alttpo/pico-cart-snes/v1/v1-back.jpg

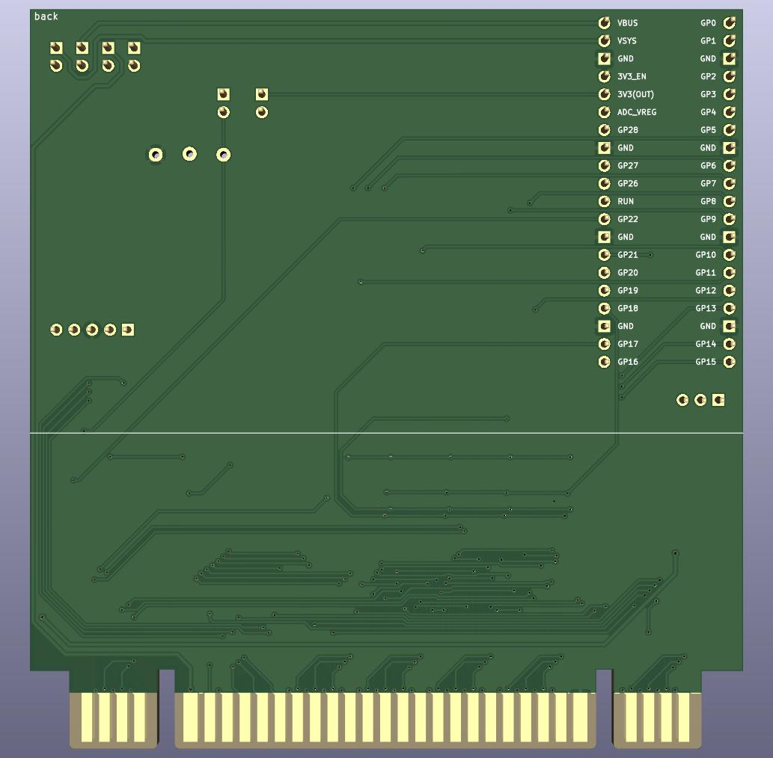
v1/v1-back.jpg
