alttpo/pico-cart-snes/v1/v1-front.jpg

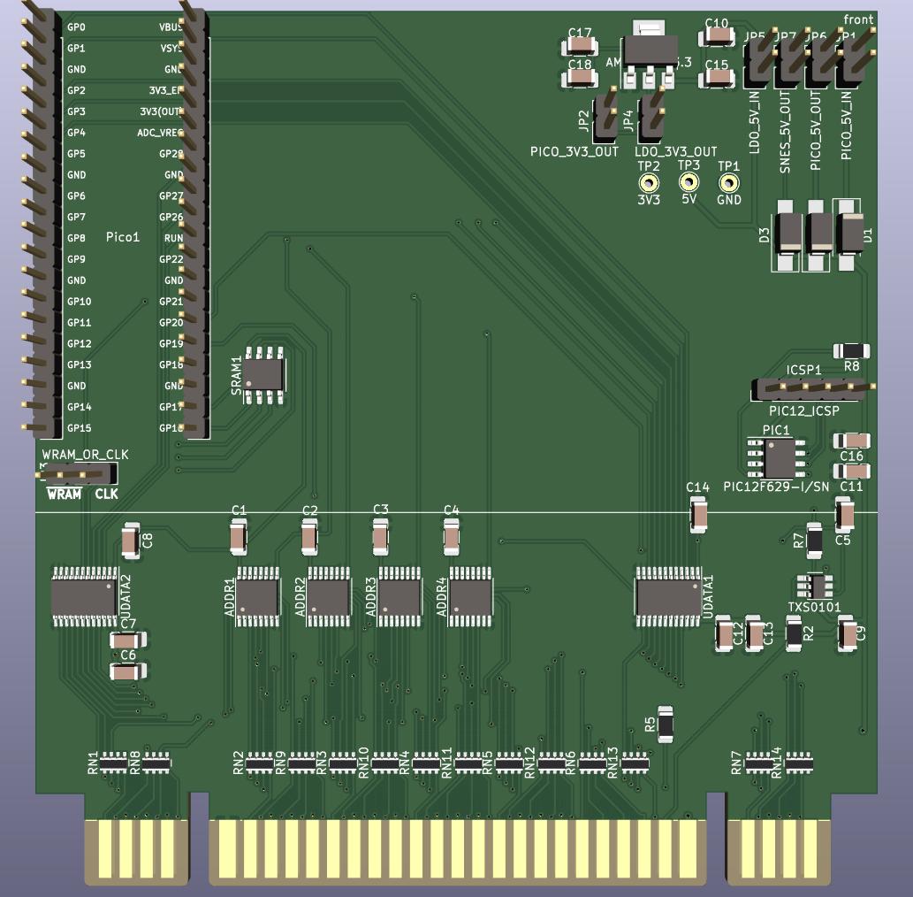
v1/v1-front.jpg
