alttpo/pico-cart-snes/README.md

# pico-cart-snes
Raspberry Pi Pico SNES flash cart (no SD card, WIP)
