alttpo/pico-cart-snes/(threads)

Thread 1 (2023-11-23):

how can i burn the snes rom into pico?

hualazimo7, 2023-11-23:
i got all the elements and the pcb, and what should i do next?

hualazimo7, 2023-11-23:
beg your help~

JamesDunne, 2023-11-23:
this project isn't capable of loading a rom yet.
