alttpo/pico-cart-snes/v1/v1.pdf

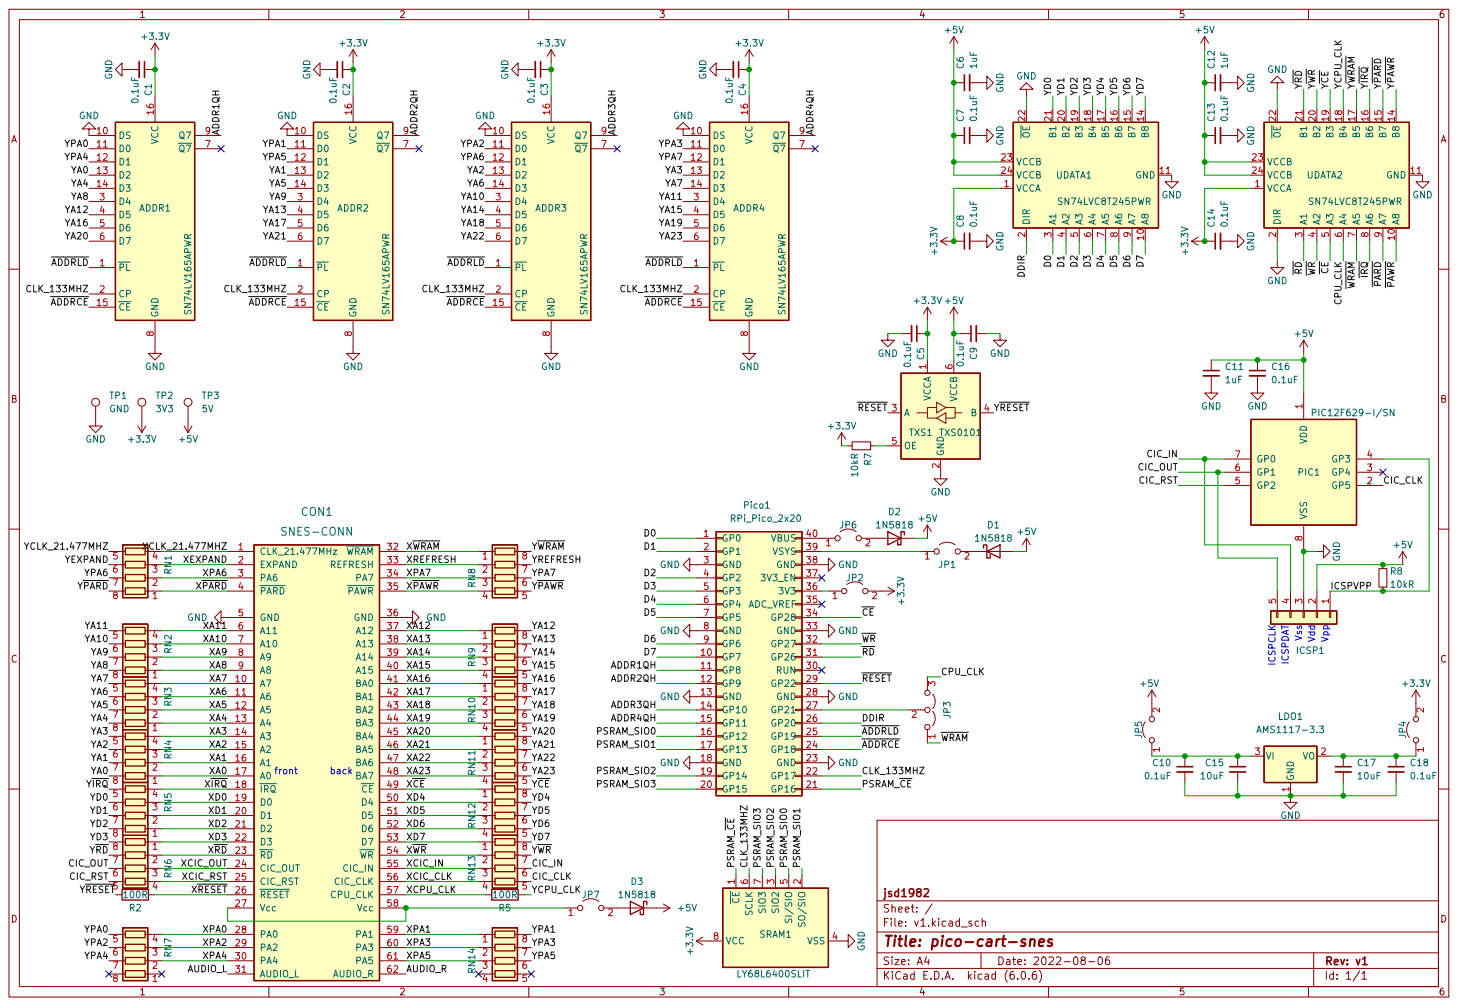
[picture p3: page 1]

A7 10 A6 11 A5 12 A4 13 A3 14 A2 15 A1 16 A0 17 ~{IRQ} 18 D0 19 EXPAND 2 D1 20 D2 21 D3 22 ~{RD} 23 CIC_OUT 24 CIC_RST 25 ~{RESET} 26 Vcc 27 PA0 28 PA2 29 PA6 3 PA4 30 AUDIO_L 31 | 1 | 8 RN14 CLK_21.477MHz 1

3 | | 2 | | 8 RN10 GND 8 RN9 7

3 | 2 | 8 RN11 7

X~{RD} XD2 XD3 XD1 XA1 X~{IRQ} XA0 | XCIC_CLK 1

3 | 2 | 8 RN12

1 | XD7 XCIC_IN 1
2 | 2 | R5 | 8 RN13 7

jsd1982
File: v1.kicad_sch Sheet: /
Id: 1/1 Title: pico-cart-snes
