alttpo/pico-cart-snes/v0/v0-schematic.pdf

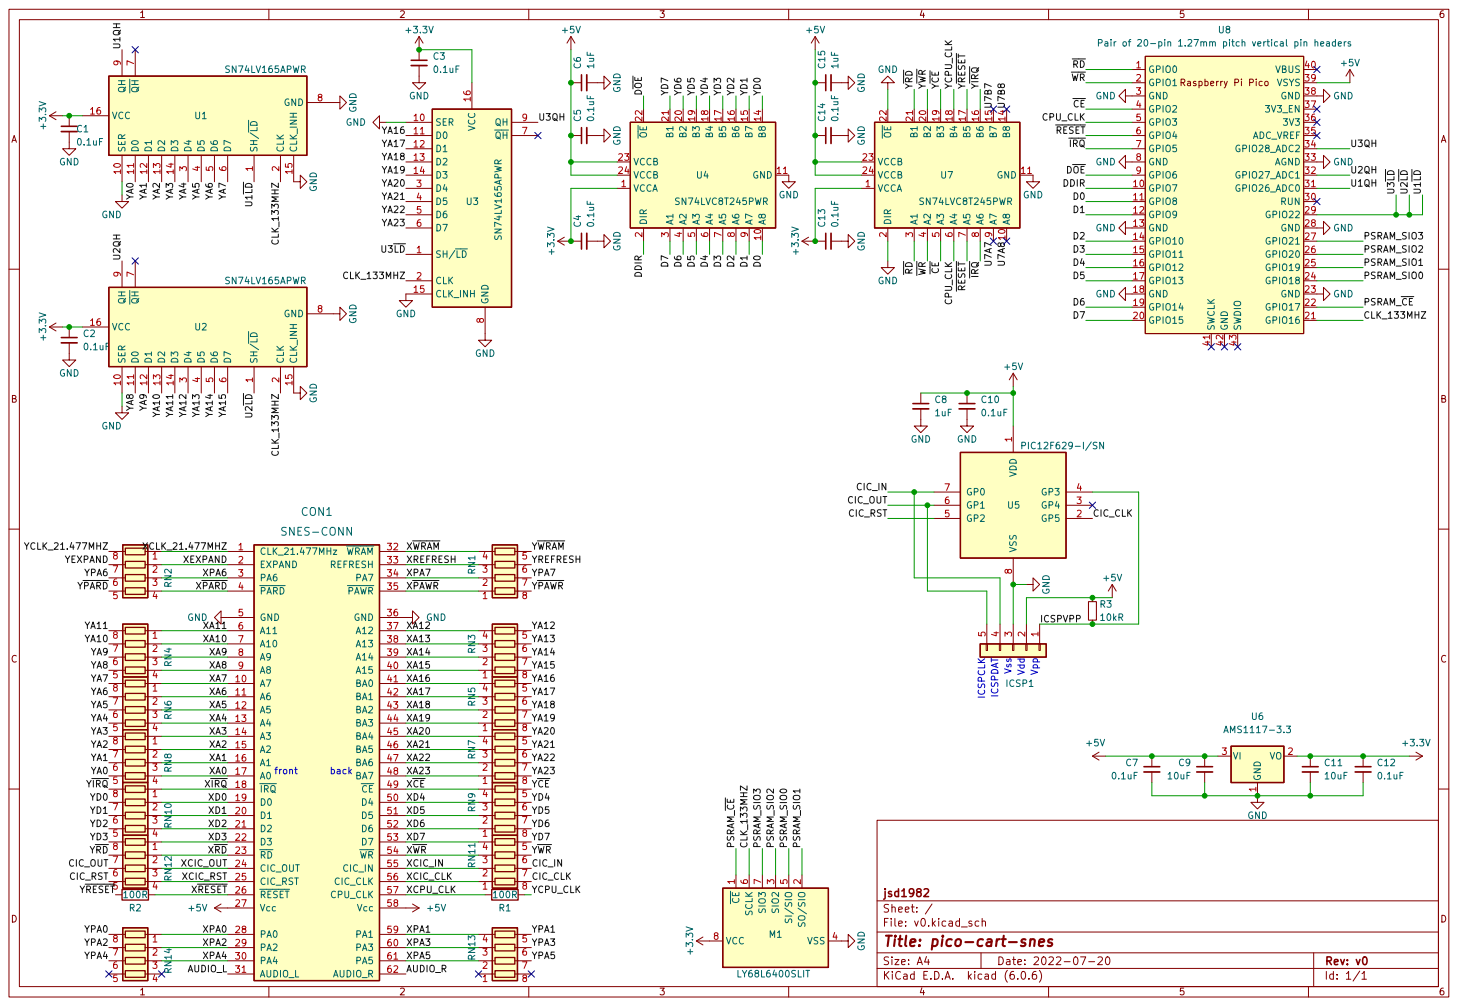
[picture p4: page 1]

9 U2 SN74LV165APWR SH/~{LD} 1 SER 10 D0 11 D1 12 D2 13 D3 14 CLK_INH 15 VCC 16 CLK

XPA4 AUDIO_L XA11 XA10 X~{PARD} 3 | 2

2 | 3 | 8 RN3 6

1 | 4 X~{WR} XCIC_IN | | 5
3 | XCIC_CLK 2 | R1 | 8 RN11 7

jsd1982
File: v0.kicad_sch Sheet: /
Id: 1/1 Title: pico-cart-snes
