alttpo/pico-cart-snes/v1/v1.kicad_pcb

## KiCad design v1/v1.kicad_pcb (2022-08-20)

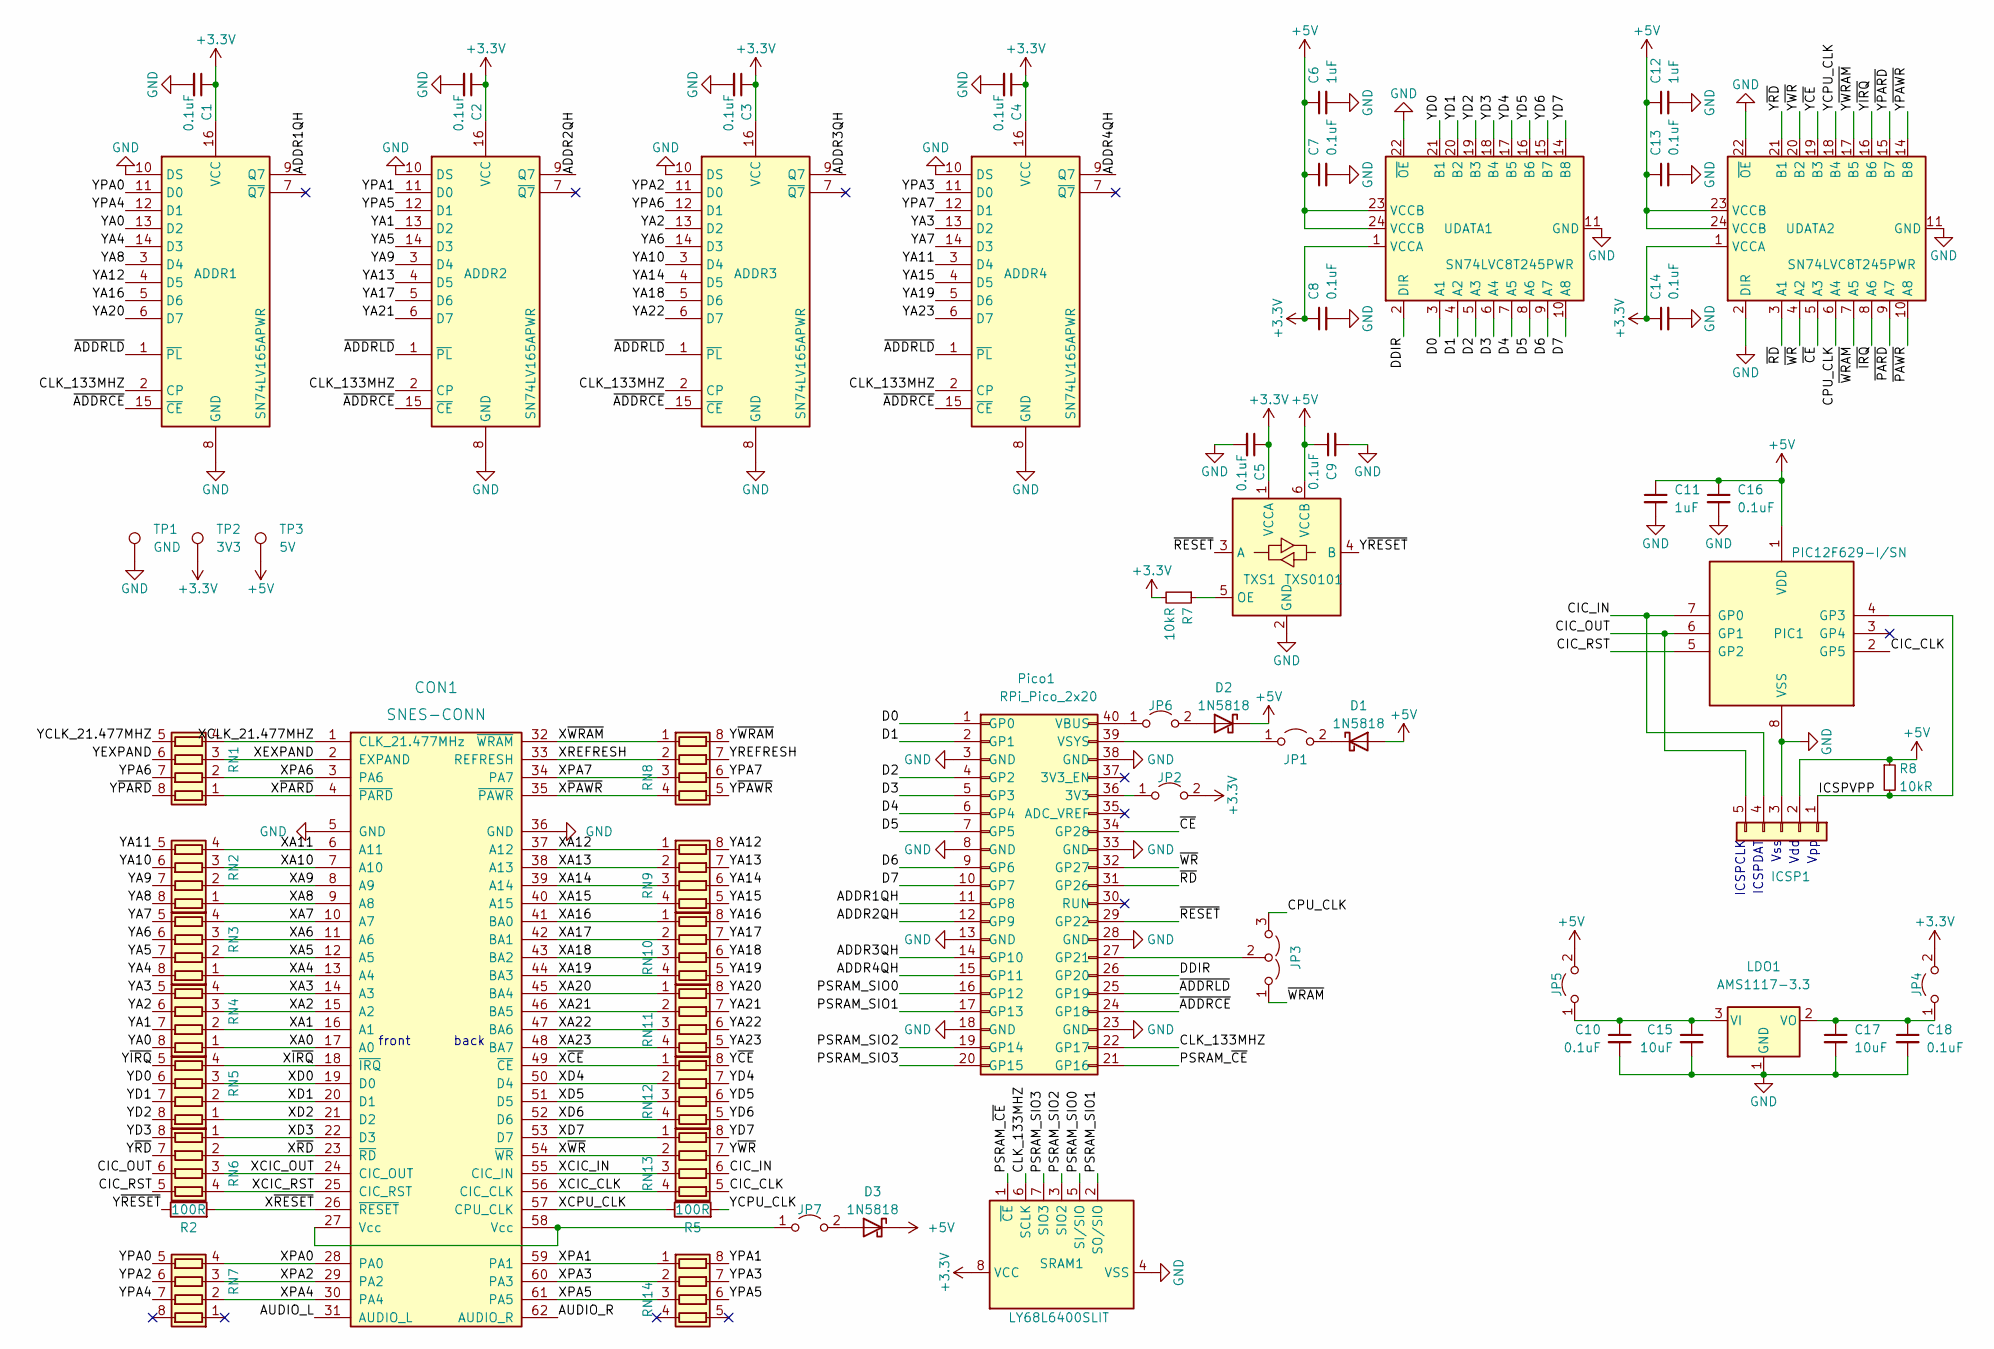
[picture p5: schematic v1.kicad_sch, pico-cart-snes]

Parts:
ADDR1, ADDR2, ADDR3, ADDR4: SN74LV165APWR; TSSOP-16_4.4x5mm_P0.65mm; LCSC C201716
C1, C2, C3, C4, C5, C7, C8, C9, C10, C13, C14, C16, C18: 0.1uF; C_1206_3216Metric_Pad1.33x1.80mm_HandSolder; JLC 1206
C6, C11, C12: 1uF; C_1206_3216Metric_Pad1.33x1.80mm_HandSolder; JLC 1206
C15, C17: 10uF; C_1206_3216Metric_Pad1.33x1.80mm_HandSolder; JLC 1206
CON1: SNES-CONN; SNESCART_EXT2
D1, D2, D3: 1N5818; D_SMA_Handsoldering; LCSC C513476
ICSP1: PIC12_ICSP; PinHeader_1x05_P2.54mm_Vertical; LCSC C390683
JP1: PICO_5V_IN; PinHeader_1x02_P2.54mm_Vertical; LCSC C390678
JP2: PICO_3V3_OUT; PinHeader_1x02_P2.54mm_Vertical; LCSC C390678
JP3: WRAM_OR_CLK; PinHeader_1x03_P2.54mm_Vertical; LCSC C390679
JP4: LDO_3V3_OUT; PinHeader_1x02_P2.54mm_Vertical; LCSC C390678
JP5: LDO_5V_IN; PinHeader_1x02_P2.54mm_Vertical; LCSC C390678
JP6: PICO_5V_OUT; PinHeader_1x02_P2.54mm_Vertical; LCSC C390678
JP7: SNES_5V_OUT; PinHeader_1x02_P2.54mm_Vertical; LCSC C390678
LDO1: AMS1117-3.3; SOT-223-3_TabPin2; LCSC C426566
PIC1: PIC12F629-I/SN; SOIC-8_3.9x4.9mm_P1.27mm; LCSC C8226
Pico1: RPi_Pico_2x20; LCSC C429964
R2, R5: 100R; R_1206_3216Metric_Pad1.30x1.75mm_HandSolder; JLC 1206
R7, R8: 10kR; R_1206_3216Metric_Pad1.30x1.75mm_HandSolder; JLC 1206
RN1, RN2, RN3, RN4, RN5, RN6, RN7, RN8, RN9, RN10, RN11, RN12, RN13, RN14: 100R; R_Array_Concave_4x0603; LCSC C79203
SRAM1: LY68L6400SLIT; SOIC-8_3.9x4.9mm_P1.27mm; LCSC C261881
TP1: GND; TestPoint_THTPad_D2.0mm_Drill1.0mm
TP2: 3V3; TestPoint_THTPad_D2.0mm_Drill1.0mm
TP3: 5V; TestPoint_THTPad_D2.0mm_Drill1.0mm
TXS1: TXS0101; SOT-23-6_Handsoldering; LCSC C2677420
UDATA1, UDATA2: SN74LVC8T245PWR; TSSOP-24_4.4x7.8mm_P0.65mm; LCSC C27643

Connections:
+3.3V: ADDR1.16 (VCC), ADDR2.16 (VCC), ADDR3.16 (VCC), ADDR4.16 (VCC), C1.1, C2.1, C3.1, C4.1, C5.1, C8.1, C14.1, JP2.2 (B), JP4.2 (B), R7.2, SRAM1.8 (VCC), TP2.1, TXS1.1 (VCCA), UDATA1.1 (VCCA), UDATA2.1 (VCCA)
+5V: C6.1, C7.1, C9.1, C11.1, C12.1, C13.1, C16.1, D1.2 (A), D2.1 (K), D3.1 (K), ICSP1.2, JP5.2 (B), PIC1.1 (VDD), R8.1, TP3.1, TXS1.6 (VCCB), UDATA1.23 (VCCB), UDATA1.24 (VCCB), UDATA2.23 (VCCB), UDATA2.24 (VCCB)
/ADDR1QH: ADDR1.9 (Q7), Pico1.11 (GP8)
/ADDR2QH: ADDR2.9 (Q7), Pico1.12 (GP9)
/ADDR3QH: ADDR3.9 (Q7), Pico1.14 (GP10)
/ADDR4QH: ADDR4.9 (Q7), Pico1.15 (GP11)
/AUDIO_L: CON1.31 (AUDIO_L)
/AUDIO_R: CON1.62 (AUDIO_R)
/CIC_CLK: PIC1.2 (GP5), RN13.5 (R4.2)
/CIC_IN: ICSP1.4, PIC1.7 (GP0), RN13.6 (R3.2)
/CIC_OUT: ICSP1.5, PIC1.6 (GP1), RN6.6 (R3.2)
/CIC_RST: PIC1.5 (GP2), RN6.5 (R4.2)
/CLK_133MHZ: ADDR1.2 (CP), ADDR2.2 (CP), ADDR3.2 (CP), ADDR4.2 (CP), Pico1.22 (GP17), SRAM1.6 (SCLK)
/CPU_CLK: JP3.3 (B), UDATA2.6 (A4)
/D0: Pico1.1 (GP0), UDATA1.3 (A1)
/D1: Pico1.2 (GP1), UDATA1.4 (A2)
/D2: Pico1.4 (GP2), UDATA1.5 (A3)
/D3: Pico1.5 (GP3), UDATA1.6 (A4)
/D4: Pico1.6 (GP4), UDATA1.7 (A5)
/D5: Pico1.7 (GP5), UDATA1.8 (A6)
/D6: Pico1.9 (GP6), UDATA1.9 (A7)
/D7: Pico1.10 (GP7), UDATA1.10 (A8)
/DDIR: Pico1.26 (GP20), UDATA1.2 (DIR)
/ICSPVPP: ICSP1.1, PIC1.4 (GP3), R8.2
/PSRAM_SIO0: Pico1.16 (GP12), SRAM1.5 (SI/SIO)
/PSRAM_SIO1: Pico1.17 (GP13), SRAM1.2 (SO/SIO)
/PSRAM_SIO2: Pico1.19 (GP14), SRAM1.3 (SIO2)
/PSRAM_SIO3: Pico1.20 (GP15), SRAM1.7 (SIO3)
/PSRAM_~CE: Pico1.21 (GP16), SRAM1.1 (~CE)
/XA0: CON1.17 (A0), RN4.1 (R1.1)
/XA1: CON1.16 (A1), RN4.2 (R2.1)
/XA2: CON1.15 (A2), RN4.3 (R3.1)
/XA3: CON1.14 (A3), RN4.4 (R4.1)
/XA4: CON1.13 (A4), RN3.1 (R1.1)
/XA5: CON1.12 (A5), RN3.2 (R2.1)
/XA6: CON1.11 (A6), RN3.3 (R3.1)
/XA7: CON1.10 (A7), RN3.4 (R4.1)
/XA8: CON1.9 (A8), RN2.1 (R1.1)
/XA9: CON1.8 (A9), RN2.2 (R2.1)
/XA10: CON1.7 (A10), RN2.3 (R3.1)
/XA11: CON1.6 (A11), RN2.4 (R4.1)
/XA12: CON1.37 (A12), RN9.1 (R1.1)
/XA13: CON1.38 (A13), RN9.2 (R2.1)
/XA14: CON1.39 (A14), RN9.3 (R3.1)
/XA15: CON1.40 (A15), RN9.4 (R4.1)
/XA16: CON1.41 (BA0), RN10.1 (R1.1)
/XA17: CON1.42 (BA1), RN10.2 (R2.1)
/XA18: CON1.43 (BA2), RN10.3 (R3.1)
/XA19: CON1.44 (BA3), RN10.4 (R4.1)
/XA20: CON1.45 (BA4), RN11.1 (R1.1)
/XA21: CON1.46 (BA5), RN11.2 (R2.1)
/XA22: CON1.47 (BA6), RN11.3 (R3.1)
/XA23: CON1.48 (BA7), RN11.4 (R4.1)
/XCIC_CLK: CON1.56 (CIC_CLK), RN13.4 (R4.1)
/XCIC_IN: CON1.55 (CIC_IN), RN13.3 (R3.1)
/XCIC_OUT: CON1.24 (CIC_OUT), RN6.3 (R3.1)
/XCIC_RST: CON1.25 (CIC_RST), RN6.4 (R4.1)
/XCLK_21.477MHZ: CON1.1 (CLK_21.477MHz), RN1.4 (R4.1)
/XCPU_CLK: CON1.57 (CPU_CLK), R5.1
/XD0: CON1.19 (D0), RN5.3 (R3.1)
/XD1: CON1.20 (D1), RN5.2 (R2.1)
/XD2: CON1.21 (D2), RN5.1 (R1.1)
/XD3: CON1.22 (D3), RN6.1 (R1.1)
/XD4: CON1.50 (D4), RN12.2 (R2.1)
/XD5: CON1.51 (D5), RN12.3 (R3.1)
/XD6: CON1.52 (D6), RN12.4 (R4.1)
/XD7: CON1.53 (D7), RN13.1 (R1.1)
/XEXPAND: CON1.2 (EXPAND), RN1.3 (R3.1)
/XPA0: CON1.28 (PA0), RN7.4 (R4.1)
/XPA1: CON1.59 (PA1), RN14.1 (R1.1)
/XPA2: CON1.29 (PA2), RN7.3 (R3.1)
/XPA3: CON1.60 (PA3), RN14.2 (R2.1)
/XPA4: CON1.30 (PA4), RN7.2 (R2.1)
/XPA5: CON1.61 (PA5), RN14.3 (R3.1)
/XPA6: CON1.3 (PA6), RN1.2 (R2.1)
/XPA7: CON1.34 (PA7), RN8.3 (R3.1)
/XREFRESH: CON1.33 (REFRESH), RN8.2 (R2.1)
/X~CE: CON1.49 (~CE), RN12.1 (R1.1)
/X~IRQ: CON1.18 (~IRQ), RN5.4 (R4.1)
/X~PARD: CON1.4 (~PARD), RN1.1 (R1.1)
/X~PAWR: CON1.35 (~PAWR), RN8.4 (R4.1)
/X~RD: CON1.23 (~RD), RN6.2 (R2.1)
/X~RESET: CON1.26 (~RESET), R2.2
/X~WRAM: CON1.32 (~WRAM), RN8.1 (R1.1)
/X~WR: CON1.54 (~WR), RN13.2 (R2.1)
/YA0: ADDR1.13 (D2), RN4.8 (R1.2)
/YA1: ADDR2.13 (D2), RN4.7 (R2.2)
/YA2: ADDR3.13 (D2), RN4.6 (R3.2)
/YA3: ADDR4.13 (D2), RN4.5 (R4.2)
/YA4: ADDR1.14 (D3), RN3.8 (R1.2)
/YA5: ADDR2.14 (D3), RN3.7 (R2.2)
/YA6: ADDR3.14 (D3), RN3.6 (R3.2)
/YA7: ADDR4.14 (D3), RN3.5 (R4.2)
/YA8: ADDR1.3 (D4), RN2.8 (R1.2)
/YA9: ADDR2.3 (D4), RN2.7 (R2.2)
/YA10: ADDR3.3 (D4), RN2.6 (R3.2)
/YA11: ADDR4.3 (D4), RN2.5 (R4.2)
/YA12: ADDR1.4 (D5), RN9.8 (R1.2)
/YA13: ADDR2.4 (D5), RN9.7 (R2.2)
/YA14: ADDR3.4 (D5), RN9.6 (R3.2)
/YA15: ADDR4.4 (D5), RN9.5 (R4.2)
/YA16: ADDR1.5 (D6), RN10.8 (R1.2)
/YA17: ADDR2.5 (D6), RN10.7 (R2.2)
/YA18: ADDR3.5 (D6), RN10.6 (R3.2)
/YA19: ADDR4.5 (D6), RN10.5 (R4.2)
/YA20: ADDR1.6 (D7), RN11.8 (R1.2)
/YA21: ADDR2.6 (D7), RN11.7 (R2.2)
/YA22: ADDR3.6 (D7), RN11.6 (R3.2)
/YA23: ADDR4.6 (D7), RN11.5 (R4.2)
/YCLK_21.477MHZ: RN1.5 (R4.2)
/YCPU_CLK: R5.2, UDATA2.18 (B4)
/YD0: RN5.6 (R3.2), UDATA1.21 (B1)
/YD1: RN5.7 (R2.2), UDATA1.20 (B2)
/YD2: RN5.8 (R1.2), UDATA1.19 (B3)
/YD3: RN6.8 (R1.2), UDATA1.18 (B4)
/YD4: RN12.7 (R2.2), UDATA1.17 (B5)
/YD5: RN12.6 (R3.2), UDATA1.16 (B6)
/YD6: RN12.5 (R4.2), UDATA1.15 (B7)
/YD7: RN13.8 (R1.2), UDATA1.14 (B8)
/YEXPAND: RN1.6 (R3.2)
/YPA0: ADDR1.11 (D0), RN7.5 (R4.2)
/YPA1: ADDR2.11 (D0), RN14.8 (R1.2)
/YPA2: ADDR3.11 (D0), RN7.6 (R3.2)
/YPA3: ADDR4.11 (D0), RN14.7 (R2.2)
/YPA4: ADDR1.12 (D1), RN7.7 (R2.2)
/YPA5: ADDR2.12 (D1), RN14.6 (R3.2)
/YPA6: ADDR3.12 (D1), RN1.7 (R2.2)
/YPA7: ADDR4.12 (D1), RN8.6 (R3.2)
/YREFRESH: RN8.7 (R2.2)
/Y~CE: RN12.8 (R1.2), UDATA2.19 (B3)
/Y~IRQ: RN5.5 (R4.2), UDATA2.16 (B6)
/Y~PARD: RN1.8 (R1.2), UDATA2.15 (B7)
/Y~PAWR: RN8.5 (R4.2), UDATA2.14 (B8)
/Y~RD: RN6.7 (R2.2), UDATA2.21 (B1)
/Y~RESET: R2.1, TXS1.4 (B)
/Y~WRAM: RN8.8 (R1.2), UDATA2.17 (B5)
/Y~WR: RN13.7 (R2.2), UDATA2.20 (B2)
/~ADDRCE: ADDR1.15 (~CE), ADDR2.15 (~CE), ADDR3.15 (~CE), ADDR4.15 (~CE), Pico1.24 (GP18)
/~ADDRLD: ADDR1.1 (~PL), ADDR2.1 (~PL), ADDR3.1 (~PL), ADDR4.1 (~PL), Pico1.25 (GP19)
/~CE: Pico1.34 (GP28), UDATA2.5 (A3)
/~IRQ: UDATA2.8 (A6)
/~PARD: UDATA2.9 (A7)
/~PAWR: UDATA2.10 (A8)
/~RD: Pico1.31 (GP26), UDATA2.3 (A1)
/~RESET: Pico1.29 (GP22), TXS1.3 (A)
/~WRAM: JP3.1 (A), UDATA2.7 (A5)
/~WR: Pico1.32 (GP27), UDATA2.4 (A2)
GND: ADDR1.8 (GND), ADDR1.10 (DS), ADDR2.8 (GND), ADDR2.10 (DS), ADDR3.8 (GND), ADDR3.10 (DS), ADDR4.8 (GND), ADDR4.10 (DS), C1.2, C2.2, C3.2, C4.2, C5.2, C6.2, C7.2, C8.2, C9.2, C10.2, C11.2, C12.2, C13.2, C14.2, C15.2, C16.2, C17.2, C18.2, CON1.5 (GND), CON1.36 (GND), ICSP1.3, LDO1.1 (GND), PIC1.8 (VSS), Pico1.3 (GND), Pico1.8 (GND), Pico1.13 (GND), Pico1.18 (GND), Pico1.23 (GND), Pico1.28 (GND), Pico1.33 (GND), Pico1.38 (GND), SRAM1.4 (VSS), TP1.1, TXS1.2 (GND), UDATA1.11 (GND), UDATA1.12 (GND), UDATA1.13 (GND), UDATA1.22 (~OE), UDATA2.2 (DIR), UDATA2.11 (GND), UDATA2.12 (GND), UDATA2.13 (GND), UDATA2.22 (~OE)
unnamed: C10.1, C15.1, JP5.1 (A), LDO1.3 (VI)
unnamed: C17.1, C18.1, JP4.1 (A), LDO1.2 (VO)
unnamed: CON1.27 (Vcc), CON1.58 (Vcc), JP7.1 (A)
unnamed: D1.1 (K), JP1.2 (B)
unnamed: D2.2 (A), JP6.2 (B)
unnamed: D3.2 (A), JP7.2 (B)
unnamed: JP1.1 (A), Pico1.39 (VSYS)
unnamed: JP2.1 (A), Pico1.36 (3V3)
unnamed: JP3.2 (C), Pico1.27 (GP21)
unnamed: JP6.1 (A), Pico1.40 (VBUS)
unnamed: R7.1, TXS1.5 (OE)

Notes on the sheet:
Vpp
Vss
ICSPCLK
Vdd
front
ICSPDAT
back

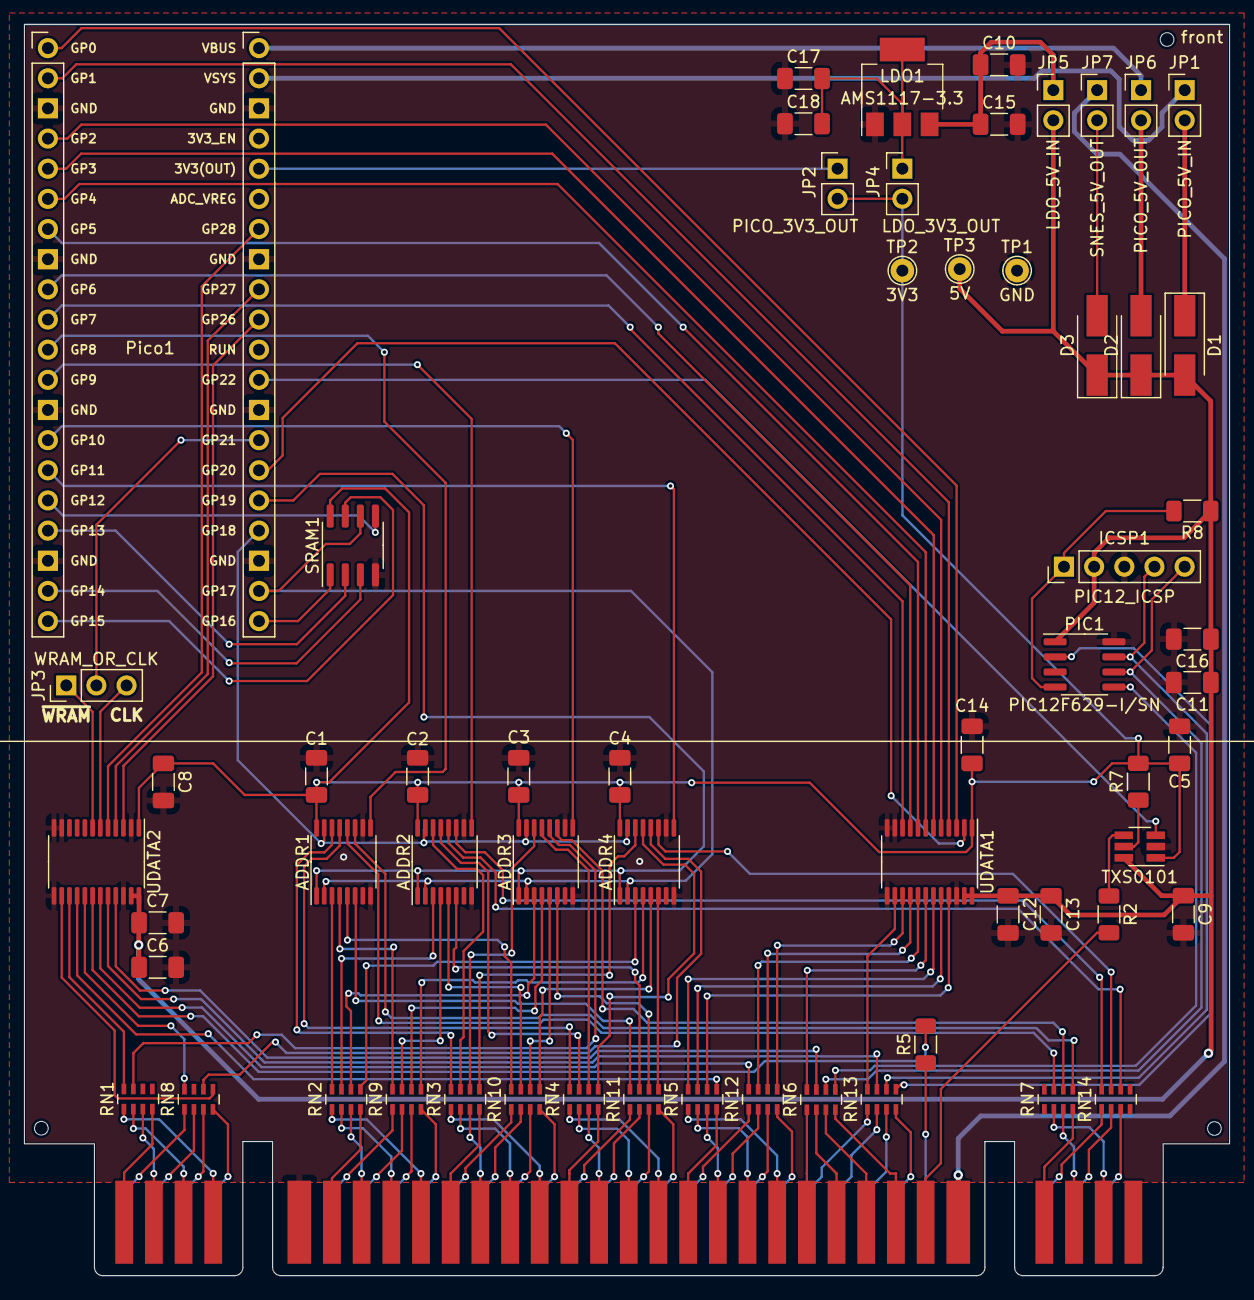
[picture p6: board v1.kicad_pcb from above]

Board: 2 copper layers, 101.5 x 105.4 mm, 62 parts (0 on the bottom side), 151 nets.
