alttpo/pico-cart-snes/v0/v0.kicad_pcb

## KiCad design v0/v0.kicad_pcb (2022-07-23, an earlier design)

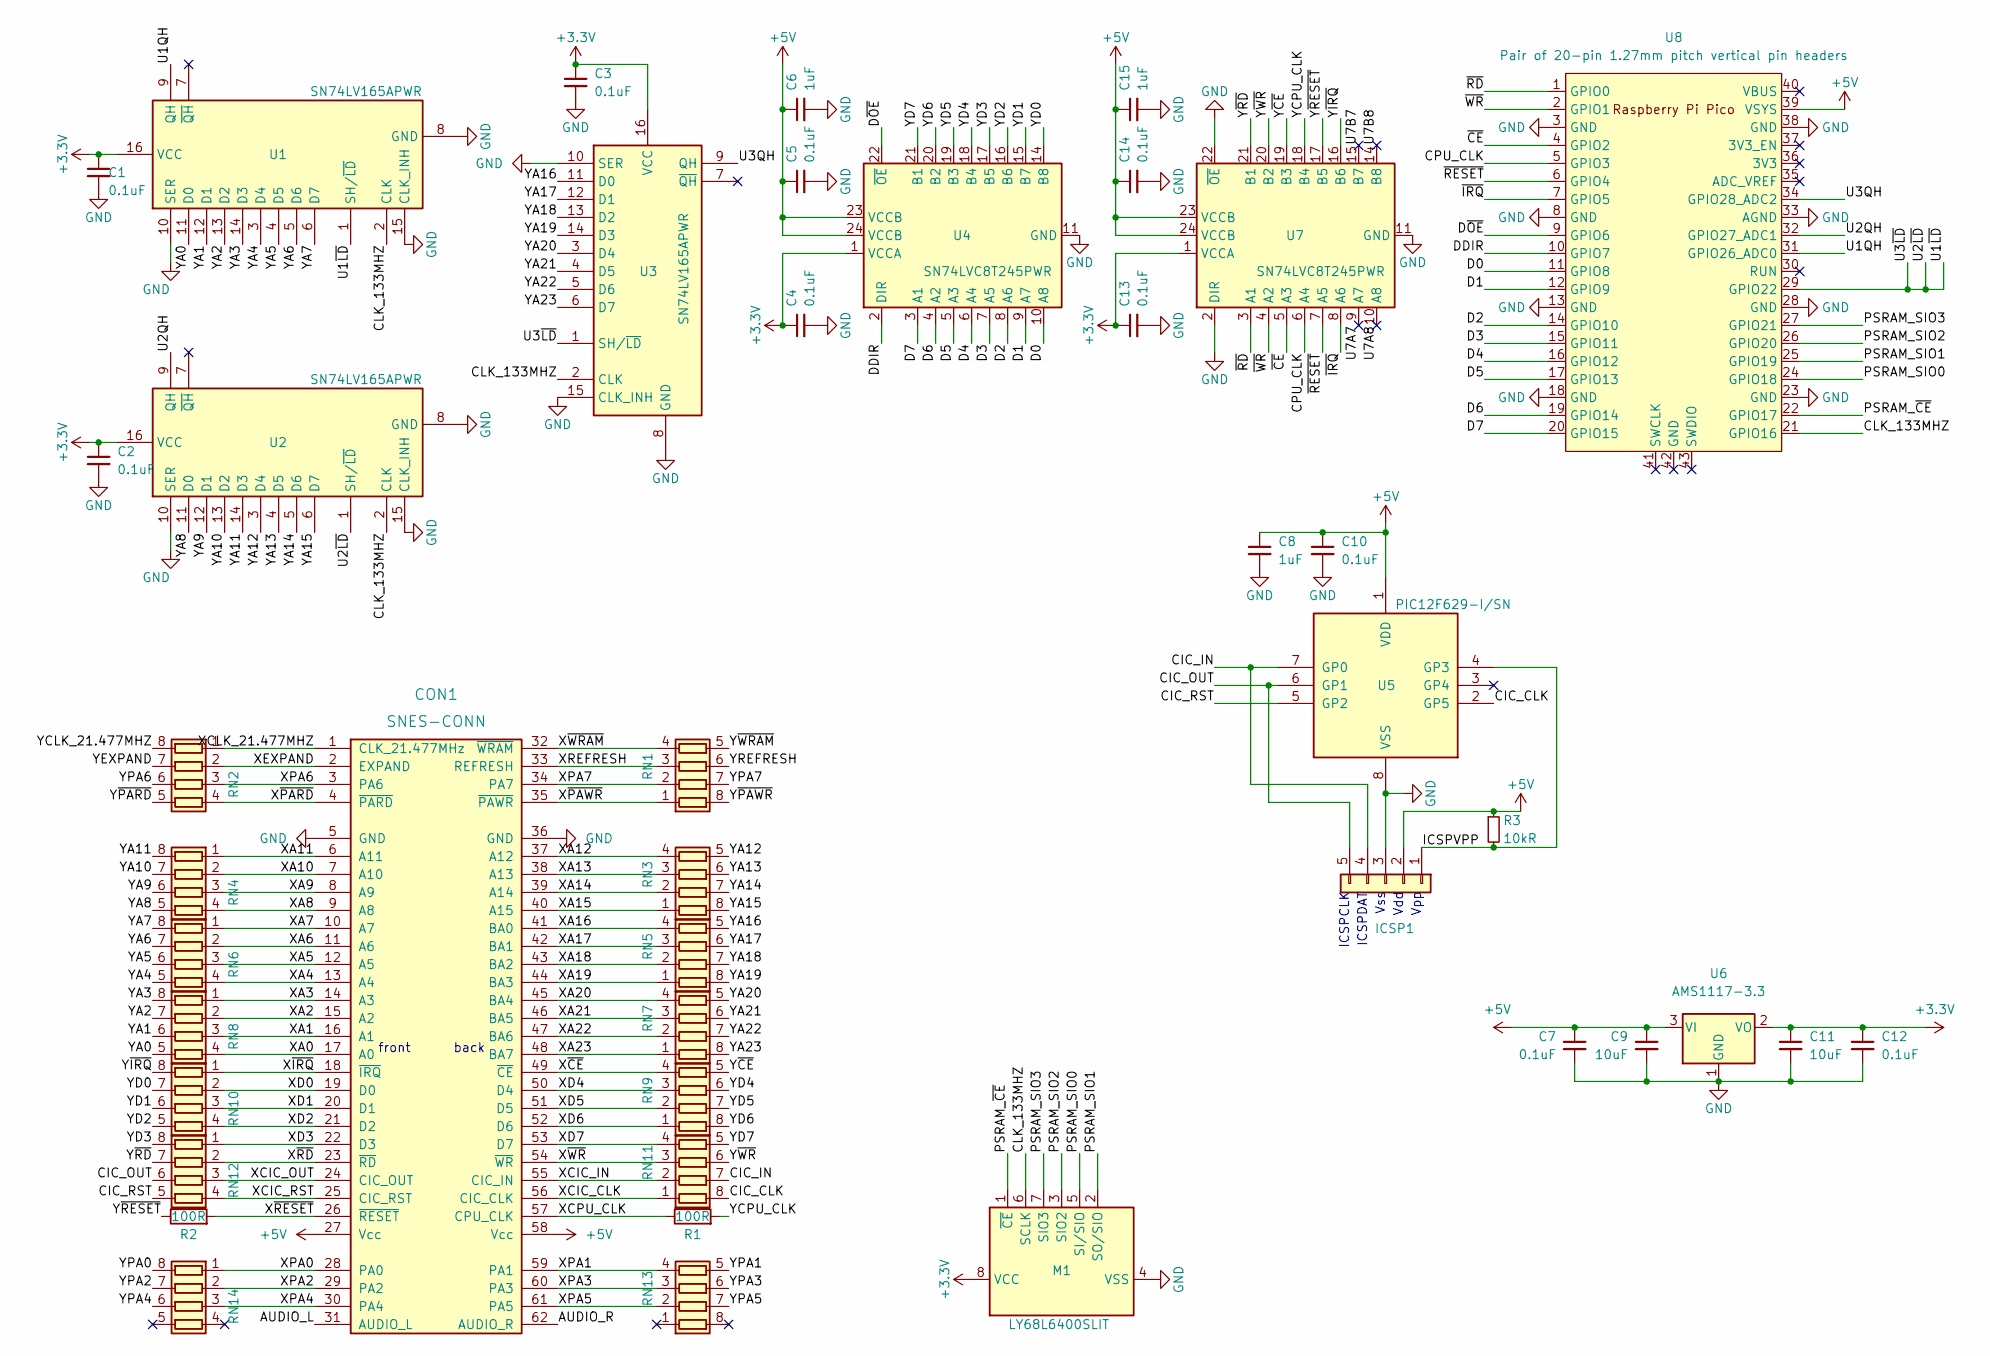
[picture p7: schematic v0.kicad_sch, pico-cart-snes]

Parts:
C1, C2, C3, C4, C5, C7, C10, C12, C13, C14: 0.1uF; C_1206_3216Metric_Pad1.33x1.80mm_HandSolder; JLC 1206
C6, C8, C15: 1uF; C_1206_3216Metric_Pad1.33x1.80mm_HandSolder; JLC 1206
C9, C11: 10uF; C_1206_3216Metric_Pad1.33x1.80mm_HandSolder; JLC 1206
CON1: SNES-CONN; SNESCART_EXT2_SMTUSB
ICSP1: Conn_01x05; PinHeader_1x05_P2.54mm_Vertical; LCSC C492404
M1: LY68L6400SLIT; SOIC-8_3.9x4.9mm_P1.27mm; LCSC LY68L6400SLIT
R1, R2: 100R; R_1206_3216Metric_Pad1.30x1.75mm_HandSolder; JLC 1206_R
R3: 10kR; R_1206_3216Metric_Pad1.30x1.75mm_HandSolder; JLC 1206_R
RN1, RN2, RN3, RN4, RN5, RN6, RN7, RN8, RN9, RN10, RN11, RN12, RN13, RN14: 100R; R_Array_Concave_4x0603; LCSC C79203
U1, U2, U3: SN74LV165APWR; TSSOP-16_4.4x5mm_P0.65mm; LCSC C201716
U4, U7: SN74LVC8T245PWR; TSSOP-24_4.4x7.8mm_P0.65mm; LCSC C27643
U5: PIC12F629-I/SN; SOIC-8_3.9x4.9mm_P1.27mm; LCSC C8226
U6: AMS1117-3.3; SOT-223-3_TabPin2; LCSC C426566
U8: Pair of 20-pin 1.27mm pitch vertical pin headers; RPi_Pico_SMD_TH

Connections:
+3.3V: C1.1, C2.1, C3.1, C4.1, C11.1, C12.1, C13.1, M1.8 (VCC), U1.16 (VCC), U2.16 (VCC), U3.16 (VCC), U4.1 (VCCA), U6.2 (VO), U7.1 (VCCA)
+5V: C5.1, C6.1, C7.1, C8.1, C9.1, C10.1, C14.1, C15.1, CON1.27 (Vcc), CON1.58 (Vcc), ICSP1.2, R3.1, U4.23 (VCCB), U4.24 (VCCB), U5.1 (VDD), U6.3 (VI), U7.23 (VCCB), U7.24 (VCCB), U8.39 (VSYS)
/AUDIO_L: CON1.31 (AUDIO_L)
/AUDIO_R: CON1.62 (AUDIO_R)
/CIC_CLK: RN11.8 (R1.2), U5.2 (GP5)
/CIC_IN: ICSP1.4, RN11.7 (R2.2), U5.7 (GP0)
/CIC_OUT: ICSP1.5, RN12.6 (R3.2), U5.6 (GP1)
/CIC_RST: RN12.5 (R4.2), U5.5 (GP2)
/CLK_133MHZ: M1.6 (SCLK), U1.2 (CLK), U2.2 (CLK), U3.2 (CLK), U8.21 (GPIO16)
/CPU_CLK: U7.6 (A4), U8.5 (GPIO3)
/D0: U4.10 (A8), U8.11 (GPIO8)
/D1: U4.9 (A7), U8.12 (GPIO9)
/D2: U4.8 (A6), U8.14 (GPIO10)
/D3: U4.7 (A5), U8.15 (GPIO11)
/D4: U4.6 (A4), U8.16 (GPIO12)
/D5: U4.5 (A3), U8.17 (GPIO13)
/D6: U4.4 (A2), U8.19 (GPIO14)
/D7: U4.3 (A1), U8.20 (GPIO15)
/DDIR: U4.2 (DIR), U8.10 (GPIO7)
/D~OE: U4.22 (~OE), U8.9 (GPIO6)
/ICSPVPP: ICSP1.1, R3.2, U5.4 (GP3)
/PSRAM_SIO0: M1.5 (SI/SIO), U8.24 (GPIO18)
/PSRAM_SIO1: M1.2 (SO/SIO), U8.25 (GPIO19)
/PSRAM_SIO2: M1.3 (SIO2), U8.26 (GPIO20)
/PSRAM_SIO3: M1.7 (SIO3), U8.27 (GPIO21)
/PSRAM_~CE: M1.1 (~CE), U8.22 (GPIO17)
/U1QH: U1.9 (QH), U8.31 (GPIO26_ADC0)
/U1~LD: U1.1 (SH/~LD), U2.1 (SH/~LD), U3.1 (SH/~LD), U8.29 (GPIO22)
/U2QH: U2.9 (QH), U8.32 (GPIO27_ADC1)
/U3QH: U3.9 (QH), U8.34 (GPIO28_ADC2)
/U7A7: U7.9 (A7)
/U7A8: U7.10 (A8)
/U7B7: U7.15 (B7)
/U7B8: U7.14 (B8)
/XA0: CON1.17 (A0), RN8.4 (R4.1)
/XA1: CON1.16 (A1), RN8.3 (R3.1)
/XA2: CON1.15 (A2), RN8.2 (R2.1)
/XA3: CON1.14 (A3), RN8.1 (R1.1)
/XA4: CON1.13 (A4), RN6.4 (R4.1)
/XA5: CON1.12 (A5), RN6.3 (R3.1)
/XA6: CON1.11 (A6), RN6.2 (R2.1)
/XA7: CON1.10 (A7), RN6.1 (R1.1)
/XA8: CON1.9 (A8), RN4.4 (R4.1)
/XA9: CON1.8 (A9), RN4.3 (R3.1)
/XA10: CON1.7 (A10), RN4.2 (R2.1)
/XA11: CON1.6 (A11), RN4.1 (R1.1)
/XA12: CON1.37 (A12), RN3.4 (R4.1)
/XA13: CON1.38 (A13), RN3.3 (R3.1)
/XA14: CON1.39 (A14), RN3.2 (R2.1)
/XA15: CON1.40 (A15), RN3.1 (R1.1)
/XA16: CON1.41 (BA0), RN5.4 (R4.1)
/XA17: CON1.42 (BA1), RN5.3 (R3.1)
/XA18: CON1.43 (BA2), RN5.2 (R2.1)
/XA19: CON1.44 (BA3), RN5.1 (R1.1)
/XA20: CON1.45 (BA4), RN7.4 (R4.1)
/XA21: CON1.46 (BA5), RN7.3 (R3.1)
/XA22: CON1.47 (BA6), RN7.2 (R2.1)
/XA23: CON1.48 (BA7), RN7.1 (R1.1)
/XCIC_CLK: CON1.56 (CIC_CLK), RN11.1 (R1.1)
/XCIC_IN: CON1.55 (CIC_IN), RN11.2 (R2.1)
/XCIC_OUT: CON1.24 (CIC_OUT), RN12.3 (R3.1)
/XCIC_RST: CON1.25 (CIC_RST), RN12.4 (R4.1)
/XCLK_21.477MHZ: CON1.1 (CLK_21.477MHz), RN2.1 (R1.1)
/XCPU_CLK: CON1.57 (CPU_CLK), R1.1
/XD0: CON1.19 (D0), RN10.2 (R2.1)
/XD1: CON1.20 (D1), RN10.3 (R3.1)
/XD2: CON1.21 (D2), RN10.4 (R4.1)
/XD3: CON1.22 (D3), RN12.1 (R1.1)
/XD4: CON1.50 (D4), RN9.3 (R3.1)
/XD5: CON1.51 (D5), RN9.2 (R2.1)
/XD6: CON1.52 (D6), RN9.1 (R1.1)
/XD7: CON1.53 (D7), RN11.4 (R4.1)
/XEXPAND: CON1.2 (EXPAND), RN2.2 (R2.1)
/XPA0: CON1.28 (PA0), RN14.1 (R1.1)
/XPA1: CON1.59 (PA1), RN13.4 (R4.1)
/XPA2: CON1.29 (PA2), RN14.2 (R2.1)
/XPA3: CON1.60 (PA3), RN13.3 (R3.1)
/XPA4: CON1.30 (PA4), RN14.3 (R3.1)
/XPA5: CON1.61 (PA5), RN13.2 (R2.1)
/XPA6: CON1.3 (PA6), RN2.3 (R3.1)
/XPA7: CON1.34 (PA7), RN1.2 (R2.1)
/XREFRESH: CON1.33 (REFRESH), RN1.3 (R3.1)
/X~CE: CON1.49 (~CE), RN9.4 (R4.1)
/X~IRQ: CON1.18 (~IRQ), RN10.1 (R1.1)
/X~PARD: CON1.4 (~PARD), RN2.4 (R4.1)
/X~PAWR: CON1.35 (~PAWR), RN1.1 (R1.1)
/X~RD: CON1.23 (~RD), RN12.2 (R2.1)
/X~RESET: CON1.26 (~RESET), R2.2
/X~WRAM: CON1.32 (~WRAM), RN1.4 (R4.1)
/X~WR: CON1.54 (~WR), RN11.3 (R3.1)
/YA0: RN8.5 (R4.2), U1.11 (D0)
/YA1: RN8.6 (R3.2), U1.12 (D1)
/YA2: RN8.7 (R2.2), U1.13 (D2)
/YA3: RN8.8 (R1.2), U1.14 (D3)
/YA4: RN6.5 (R4.2), U1.3 (D4)
/YA5: RN6.6 (R3.2), U1.4 (D5)
/YA6: RN6.7 (R2.2), U1.5 (D6)
/YA7: RN6.8 (R1.2), U1.6 (D7)
/YA8: RN4.5 (R4.2), U2.11 (D0)
/YA9: RN4.6 (R3.2), U2.12 (D1)
/YA10: RN4.7 (R2.2), U2.13 (D2)
/YA11: RN4.8 (R1.2), U2.14 (D3)
/YA12: RN3.5 (R4.2), U2.3 (D4)
/YA13: RN3.6 (R3.2), U2.4 (D5)
/YA14: RN3.7 (R2.2), U2.5 (D6)
/YA15: RN3.8 (R1.2), U2.6 (D7)
/YA16: RN5.5 (R4.2), U3.11 (D0)
/YA17: RN5.6 (R3.2), U3.12 (D1)
/YA18: RN5.7 (R2.2), U3.13 (D2)
/YA19: RN5.8 (R1.2), U3.14 (D3)
/YA20: RN7.5 (R4.2), U3.3 (D4)
/YA21: RN7.6 (R3.2), U3.4 (D5)
/YA22: RN7.7 (R2.2), U3.5 (D6)
/YA23: RN7.8 (R1.2), U3.6 (D7)
/YCLK_21.477MHZ: RN2.8 (R1.2)
/YCPU_CLK: R1.2, U7.18 (B4)
/YD0: RN10.7 (R2.2), U4.14 (B8)
/YD1: RN10.6 (R3.2), U4.15 (B7)
/YD2: RN10.5 (R4.2), U4.16 (B6)
/YD3: RN12.8 (R1.2), U4.17 (B5)
/YD4: RN9.6 (R3.2), U4.18 (B4)
/YD5: RN9.7 (R2.2), U4.19 (B3)
/YD6: RN9.8 (R1.2), U4.20 (B2)
/YD7: RN11.5 (R4.2), U4.21 (B1)
/YEXPAND: RN2.7 (R2.2)
/YPA0: RN14.8 (R1.2)
/YPA1: RN13.5 (R4.2)
/YPA2: RN14.7 (R2.2)
/YPA3: RN13.6 (R3.2)
/YPA4: RN14.6 (R3.2)
/YPA5: RN13.7 (R2.2)
/YPA6: RN2.6 (R3.2)
/YPA7: RN1.7 (R2.2)
/YREFRESH: RN1.6 (R3.2)
/Y~CE: RN9.5 (R4.2), U7.19 (B3)
/Y~IRQ: RN10.8 (R1.2), U7.16 (B6)
/Y~PARD: RN2.5 (R4.2)
/Y~PAWR: RN1.8 (R1.2)
/Y~RD: RN12.7 (R2.2), U7.21 (B1)
/Y~RESET: R2.1, U7.17 (B5)
/Y~WRAM: RN1.5 (R4.2)
/Y~WR: RN11.6 (R3.2), U7.20 (B2)
/~CE: U7.5 (A3), U8.4 (GPIO2)
/~IRQ: U7.8 (A6), U8.7 (GPIO5)
/~RD: U7.3 (A1), U8.1 (GPIO0)
/~RESET: U7.7 (A5), U8.6 (GPIO4)
/~WR: U7.4 (A2), U8.2 (GPIO1)
GND: C1.2, C2.2, C3.2, C4.2, C5.2, C6.2, C7.2, C8.2, C9.2, C10.2, C11.2, C12.2, C13.2, C14.2, C15.2, CON1.5 (GND), CON1.36 (GND), ICSP1.3, M1.4 (VSS), U1.8 (GND), U1.10 (SER), U1.15 (CLK_INH), U2.8 (GND), U2.10 (SER), U2.15 (CLK_INH), U3.8 (GND), U3.10 (SER), U3.15 (CLK_INH), U4.11 (GND), U4.12 (GND), U4.13 (GND), U5.8 (VSS), U6.1 (GND), U7.2 (DIR), U7.11 (GND), U7.12 (GND), U7.13 (GND), U7.22 (~OE), U8.3 (GND), U8.8 (GND), U8.13 (GND), U8.18 (GND), U8.23 (GND), U8.28 (GND), U8.33 (AGND), U8.38 (GND)

Notes on the sheet:
Vpp
Vss
ICSPCLK
Vdd
front
ICSPDAT
back

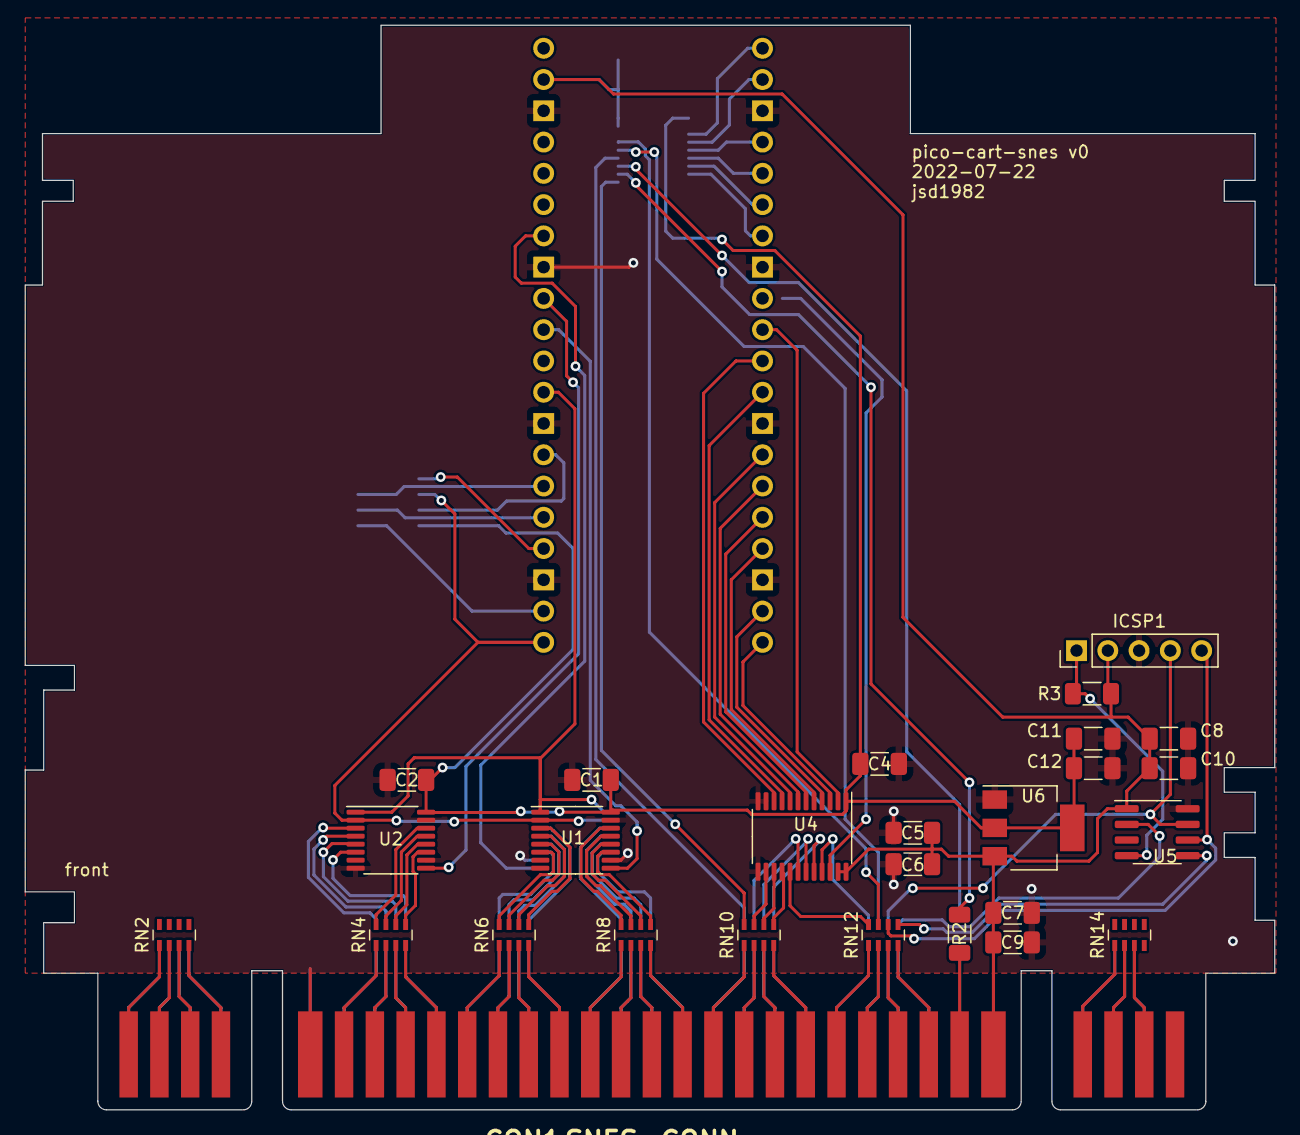
[picture p8: board v0.kicad_pcb from above]

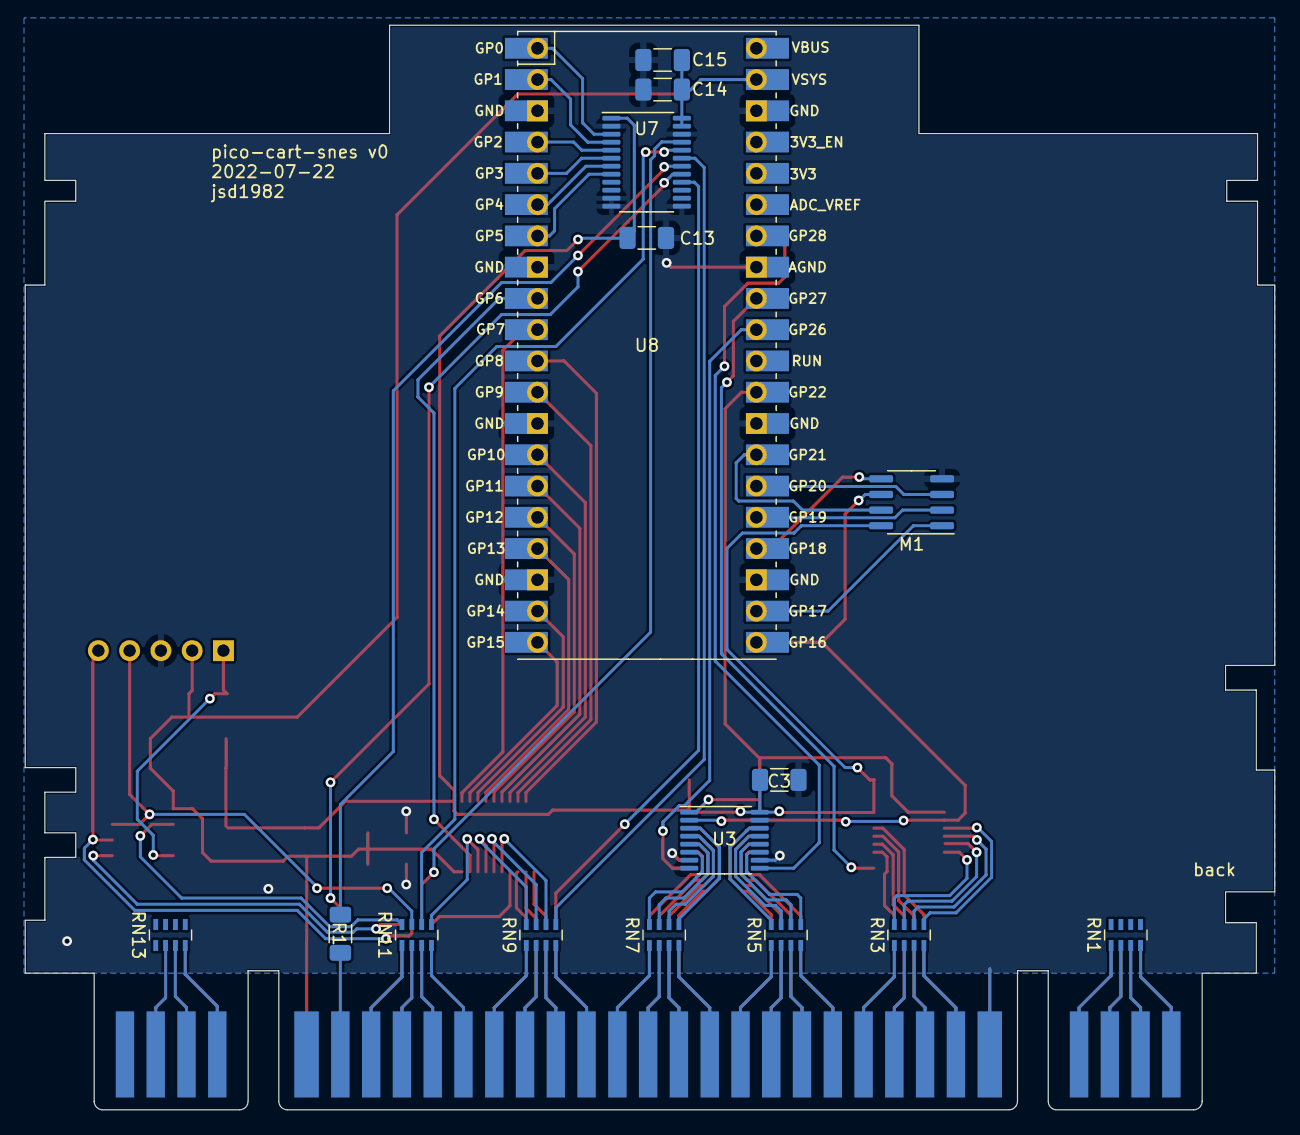
[picture p9: board v0.kicad_pcb from below]

Board: 2 copper layers, 101.5 x 88.1 mm, 43 parts (16 on the bottom side), 128 nets.
