alttpo/pico-cart-snes/(commit log)

2022-07-21 Initial commit of v0 of pico-cart-snes project including SNES connector and labeled pins
    [v0.kicad_pcb, v0.kicad_sch]
2022-07-21 Routed shift registers
    [v0.kicad_pcb, v0.kicad_sch]
2022-07-21 Route through 100R networks and into shift registers for address lines
    [v0.kicad_pcb, v0.kicad_sch]
2022-07-21 Added PIC12F and 3.3V supply; routed all nets
    [v0.kicad_pcb, v0.kicad_sch]
2022-07-22 Added RPi Pico footprint and routed traces to it
    [v0.kicad_pcb, v0.kicad_sch]
2022-07-22 Connect /OE to GND; fix up minor routing
    [v0.kicad_pcb, v0.kicad_sch]
2022-07-22 Added front and back indicators; added title
    [v0.kicad_pcb]
2022-07-22 Add title to back layer; render front/back PCB and schematic
    [v0.kicad_pcb]
2022-07-23 Critical fix to PSRAM to control /CE pin from Pico; add LCSC properties to all parts; add ICSP header for PIC12F
    [v0.kicad_pcb, v0.kicad_sch]
2022-07-23 Add JLC properties; re-render front,back,pdf
    [v0.kicad_pcb, v0.kicad_sch]
2022-07-23 Fix resistor array footprints and reroute; new layout of GPIO pins for PSRAM vs SNES address to be contiguous pin numbers
    [v0.kicad_pcb, v0.kicad_sch]
2022-07-24 Add LCSC and MOUSER part numbers
    [v0.kicad_sch]
2022-07-24 Generated gerber files
    [v0-B_Cu.gbl, v0-B_Mask.gbs, v0-B_Paste.gbp, v0-B_Silkscreen.gbo, v0-Edge_Cuts.gm1, v0-F_Cu.gtl, v0-F_Mask.gts, v0-F_Paste.gtp]
2022-07-30 Made v1 copy of v0 with new routing for diode and jumper for VSYS of Pico
    [v1.kicad_pcb, v1.kicad_sch]
2022-07-30 v1: replace Pico component with pair of pin headers
    [v1.kicad_pcb, v1.kicad_sch]
2022-08-06 v1: redo shift regs; redo gpio pin assignments; add jumpers for LDO vs Pico 3V3 power supply; use TXS0101 for /RESET
    [v1.kicad_pcb, v1.kicad_sch]
2022-08-07 v1: fixed /WRAM vs CPU_CLK jumper selector to make sense; lots of PCB routing decisions
    [v1.kicad_pcb, v1.kicad_sch]
2022-08-09 v1: lots of routing and better placement of components
    [v1.kicad_pcb, v1.kicad_sch]
2022-08-09 v1: cleaned up more routing
    [v1.kicad_pcb]
2022-08-09 v1: more routing progress
    [v1.kicad_pcb]
2022-08-10 v1: completed routing
    [v1.kicad_pcb]
2022-08-10 v1: added jumper and diode for SNES 5V supply feeding +5V rail
    [v1.kicad_pcb, v1.kicad_sch]
2022-08-10 v1: increase 5V traces to 0.5mm; add renders
    [v1.kicad_pcb]
2022-08-10 v1: updated footprint of RPi Pico to include pin labels; added test points for power rails
    [v1.kicad_pcb, v1.kicad_sch]
2022-08-10 v1: added LCSC part numbers; switched out diodes for SMT; 74LV166A is out of stock at LCSC so need to replace it
    [v1.kicad_pcb, v1.kicad_sch]
2022-08-11 v1: restarting routing of shift registers in new orientation with replacement components
    [v1.kicad_pcb, v1.kicad_sch]
2022-08-18 v1: switched back to TSSOP-16 package shift register for better switching characteristics; routed entire pcb
    [v1.kicad_pcb, v1.kicad_sch]
2022-08-18 v1: gerbers generated and sent to JLCPCB for assembly
    [v1-B_Cu.gbl, v1-B_Mask.gbs, v1-B_Paste.gbp, v1-B_Silkscreen.gbo, v1-Edge_Cuts.gm1, v1-F_Cu.gtl, v1-F_Mask.gts, v1-F_Paste.gtp]
2022-08-19 v1: regenerate gerber and drill files with tooling holes per request by JLCPCB
    [v1-B_Cu.gbl, v1-B_Mask.gbs, v1-B_Paste.gbp, v1-B_Silkscreen.gbo, v1-Edge_Cuts.gm1, v1-F_Cu.gtl, v1-F_Mask.gts, v1-F_Paste.gtp]
2022-08-20 v1: regenerate gerbers with footprint values rendered on silkscreen; these will be missing on initial JLCPCB order
    [v1-B_Cu.gbl, v1-B_Mask.gbs, v1-B_Paste.gbp, v1-B_Silkscreen.gbo, v1-Edge_Cuts.gm1, v1-F_Cu.gtl, v1-F_Mask.gts, v1-F_Paste.gtp]
2022-08-29 fw: a decent first pass at attempting to communicate with PSRAM via PIO SPI
2022-08-29 fw: working SPI read EID command; C control over CE# pin is necessary; PIO controls CLK and IO instead
2022-08-29 fw: mark psram functions time critical to get logic analyzer capture back; CE#=0 is too long and CE#=1 is too short
    [cart.c, psram.c, psram.h]
2022-08-30 fw: PIO code for partially successful SPI; misaligned reads
    [cart.c, psram.c]
2022-08-31 fw: working PIO for SPI with write and read commands
2022-08-31 fw: double clock speed and double PIO sample loops
2022-08-31 fw: enable DMA transfers from RX FIFO for SPI/QSPI
2022-09-04 fw: doing simple logic_analyzer read testing to see whats on the pins for the other devices; running into pico stdio_usb issues
    [cart.c, logic_analyzer.c]
2022-09-05 fw: TODO note about plan with PIO and DMA channels
2022-09-05 fw: move prototype code to proto/
2022-09-05 fw: reset to basic PIO program to PSRAM SPI to emit arbitrary bytes on the wire with auto-control of PSRAM_CE# line
    [logic_analyzer.c, logic_analyzer.h, main.c]
2022-09-06 fw: fixed to not skip second command
    [main.c]
2022-09-06 fw: implement QPI mode switch and QPI write/read PIOs
2022-09-06 fw: fixed qpi read timing
    [main.c]
